rancidone/cat-light/pcb/CatLightPocket/CatLightPocket.kicad_pcb

## KiCad design pcb/CatLightPocket/CatLightPocket.kicad_pcb (2026-11-08)

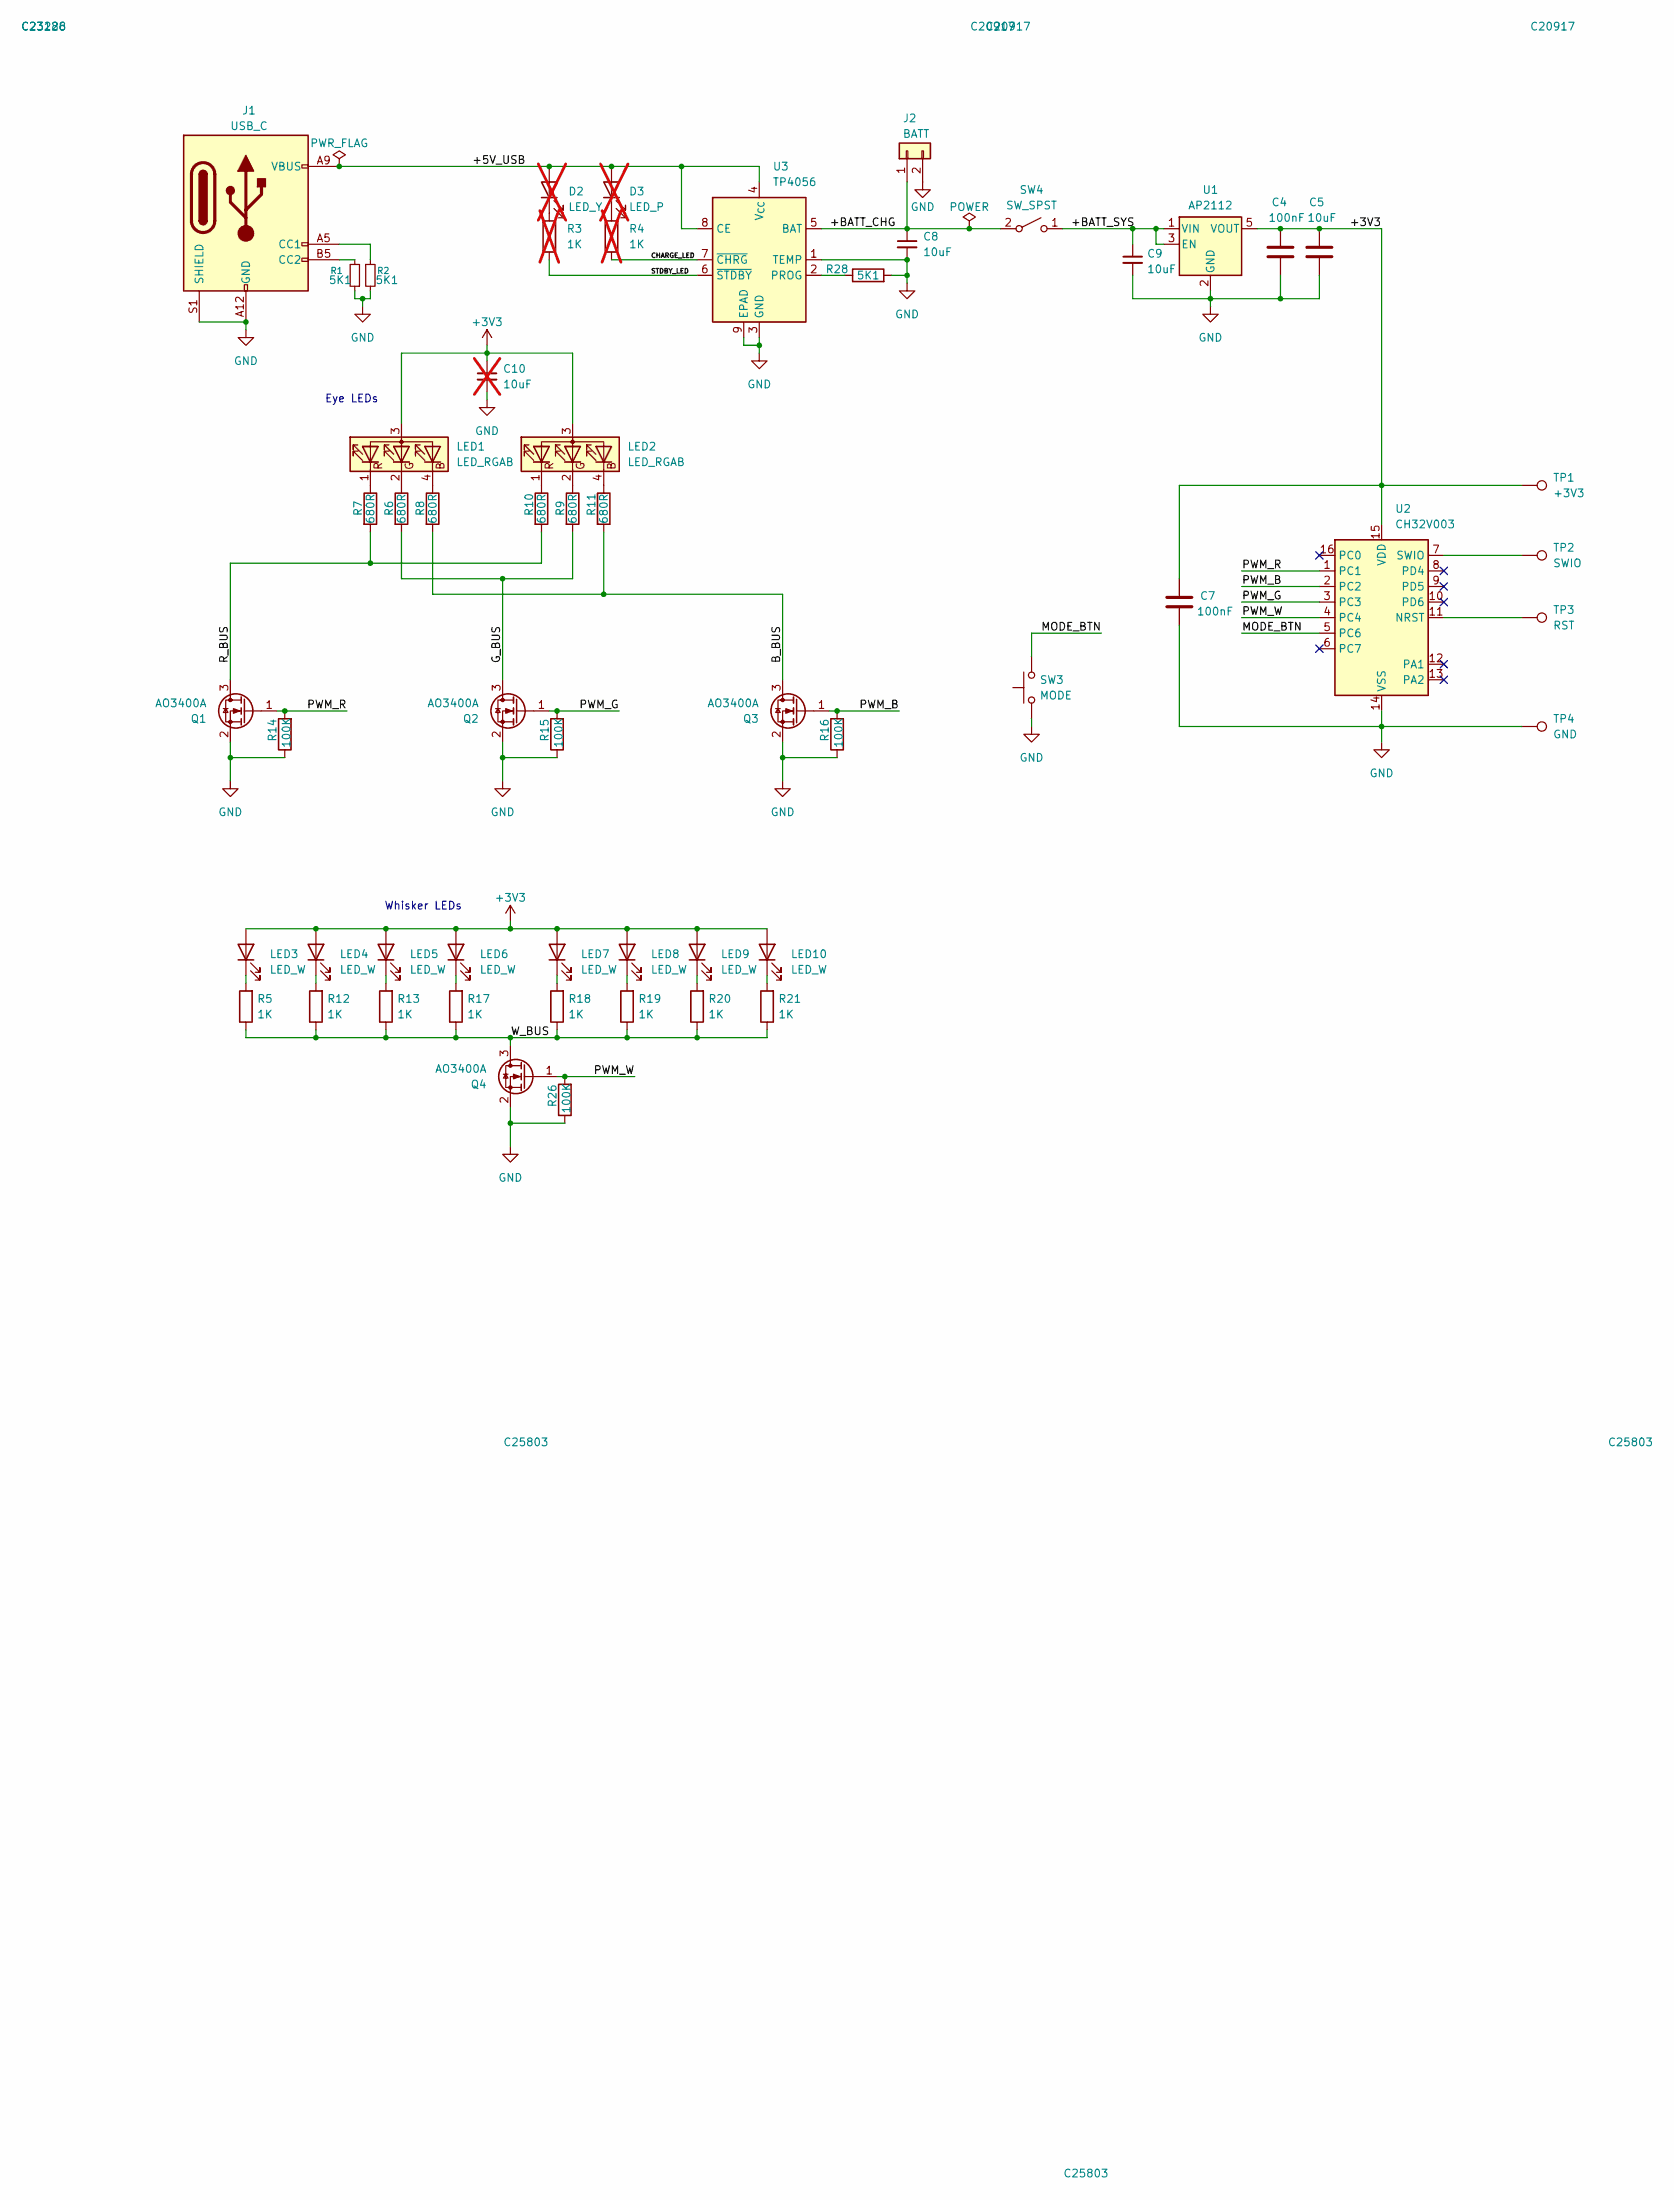
[picture p1: schematic CatLightPocket.kicad_sch]

Parts:
C4, C7: 100nF; C_0603_1608Metric_Pad1.08x0.95mm_HandSolder; LCSC C14663
C5: 10uF; C_0805_2012Metric_Pad1.18x1.45mm_HandSolder; LCSC C15850
C8, C9: 10uF; C_0805_2012Metric_Pad1.18x1.45mm_HandSolder
C10: 10uF; C_0805_2012Metric_Pad1.18x1.45mm_HandSolder; not fitted
D2: LED_Y; LED_0603_1608Metric_Pad1.05x0.95mm_HandSolder; not fitted
D3: LED_P; LED_0603_1608Metric_Pad1.05x0.95mm_HandSolder; not fitted
J1: USB_C; USB_C_Receptacle_HRO_TYPE-C-31-M-17
J2: BATT; JST_PH_B2B-PH-K_1x02_P2.00mm_Vertical
LED1, LED2: LED_RGAB; 0805 ARGB LED
LED3, LED4, LED5, LED6, LED7, LED8, LED9, LED10: LED_W; LED_0603_1608Metric_Pad1.05x0.95mm_HandSolder
Q1, Q2, Q3, Q4: AO3400A; SOT-23; LCSC C20917
R1, R2, R28: 5K1; R_0603_1608Metric_Pad0.98x0.95mm_HandSolder; LCSC C23186
R3, R4: 1K; R_0603_1608Metric_Pad0.98x0.95mm_HandSolder; LCSC C21190; not fitted
R5, R12, R13, R17, R18, R19, R20, R21: 1K; R_0603_1608Metric_Pad0.98x0.95mm_HandSolder; LCSC C21190
R6, R7, R8, R9, R10, R11: 680R; R_0603_1608Metric_Pad0.98x0.95mm_HandSolder; LCSC C23228
R14, R15, R16, R26: 100K; R_0603_1608Metric_Pad0.98x0.95mm_HandSolder; LCSC C25803
SW3: MODE; 6x3.5 Tactile Switch
SW4: SW_SPST; SW-MSK12C02
TP1: +3V3; TestPoint_Pad_D2.0mm
TP2: SWIO; TestPoint_Pad_D2.0mm
TP3: RST; TestPoint_Pad_D2.0mm
TP4: GND; TestPoint_Pad_D2.0mm
U1: AP2112; SOT-23-5_HandSoldering
U2: CH32V003; SOIC-16_3.9x9.9mm_P1.27mm
U3: TP4056; SOIC-8-1EP_3.9x4.9mm_P1.27mm_EP2.41x3.3mm; LCSC C16581

Connections:
+3V3: C4.1, C5.1, C7.1, C10.1, LED1.3 (A), LED2.3 (A), LED3.2 (A), LED4.2 (A), LED5.2 (A), LED6.2 (A), LED7.2 (A), LED8.2 (A), LED9.2 (A), LED10.2 (A), TP1.1 (1_1), U1.5 (VOUT), U2.15 (VDD)
/+5V_USB: D2.2 (A), D3.2 (A), J1.A9 (VBUS), J1.B9 (VBUS), U3.4 (V_{CC}), U3.8 (CE)
/+BATT_CHG: C8.1, J2.1, SW4.2 (A), U3.5 (BAT)
/+BATT_SYS: C9.1, SW4.1 (B), U1.1 (VIN), U1.3 (EN)
/B_BUS: Q3.3 (D), R8.2, R11.2
/CHARGE_LED: R4.1, U3.7 (~CHRG)
/G_BUS: Q2.3 (D), R6.2, R9.2
/MODE_BTN: SW3.2, U2.5 (PC6)
/PWM_B: Q3.1 (G), R16.2, U2.2 (PC2)
/PWM_G: Q2.1 (G), R15.2, U2.3 (PC3)
/PWM_R: Q1.1 (G), R14.2, U2.1 (PC1)
/PWM_W: Q4.1 (G), R26.2, U2.4 (PC4)
/R_BUS: Q1.3 (D), R7.2, R10.2
/STDBY_LED: R3.1, U3.6 (~STDBY)
/W_BUS: Q4.3 (D), R5.1, R12.1, R13.1, R17.1, R18.1, R19.1, R20.1, R21.1
GND: C4.2, C5.2, C7.2, C8.2, C9.2, C10.2, J1.A12 (GND), J1.B12 (GND), J1.S1 (SHIELD), J2.2, Q1.2 (S), Q2.2 (S), Q3.2 (S), Q4.2 (S), R1.1, R2.2, R14.1, R15.1, R16.1, R26.1, R28.2, SW3.1, TP4.1 (1_1), U1.2 (GND), U2.14 (VSS), U3.1 (TEMP), U3.3 (GND), U3.9 (EPAD)
unnamed: D2.1 (K), R3.2
unnamed: D3.1 (K), R4.2
unnamed: J1.A5 (CC1), R2.1
unnamed: J1.B5 (CC2), R1.2
unnamed: LED1.4 (BK), R8.1
unnamed: LED1.2 (GK), R6.1
unnamed: LED1.1 (RK), R7.1
unnamed: LED2.4 (BK), R11.1
unnamed: LED2.2 (GK), R9.1
unnamed: LED2.1 (RK), R10.1
unnamed: LED3.1 (K), R5.2
unnamed: LED4.1 (K), R12.2
unnamed: LED5.1 (K), R13.2
unnamed: LED6.1 (K), R17.2
unnamed: LED7.1 (K), R18.2
unnamed: LED8.1 (K), R19.2
unnamed: LED9.1 (K), R20.2
unnamed: LED10.1 (K), R21.2
unnamed: TP2.1 (1_1), U2.7 (SWIO)
unnamed: TP3.1 (1_1), U2.11 (NRST)
unnamed: R28.1, U3.2 (PROG)

Notes on the sheet:
Eye LEDs
Whisker LEDs

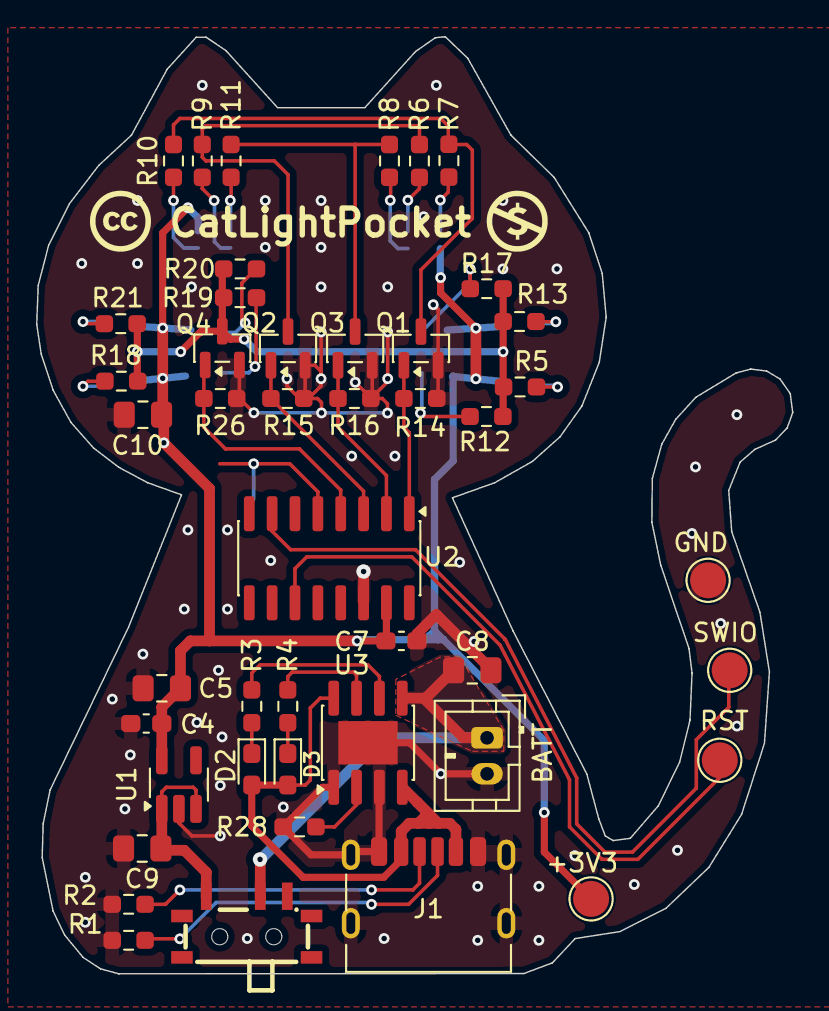
[picture p2: board CatLightPocket.kicad_pcb from above]

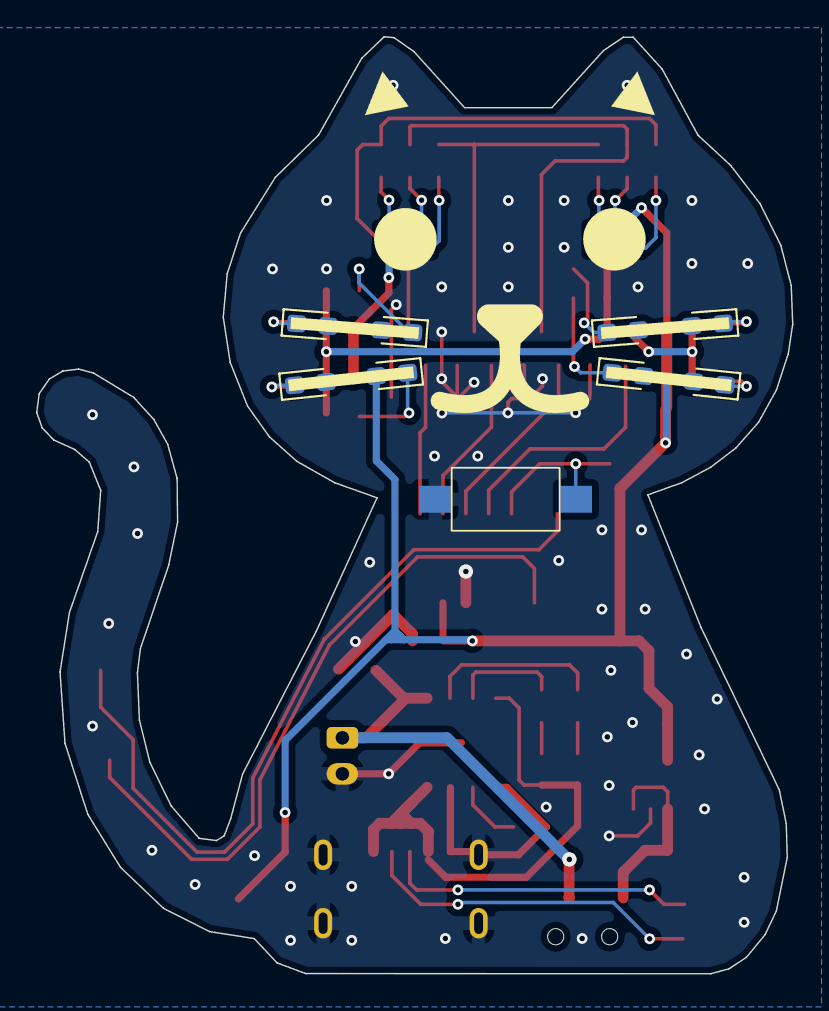
[picture p3: board CatLightPocket.kicad_pcb from below]

Board: 2 copper layers, 42.0 x 52.1 mm, 56 parts (11 on the bottom side), 37 nets.
