rancidone/cat-light/ESPLight-dev/ESPLight-dev.kicad_pcb

## KiCad design ESPLight-dev/ESPLight-dev.kicad_pcb (2026-03-18)

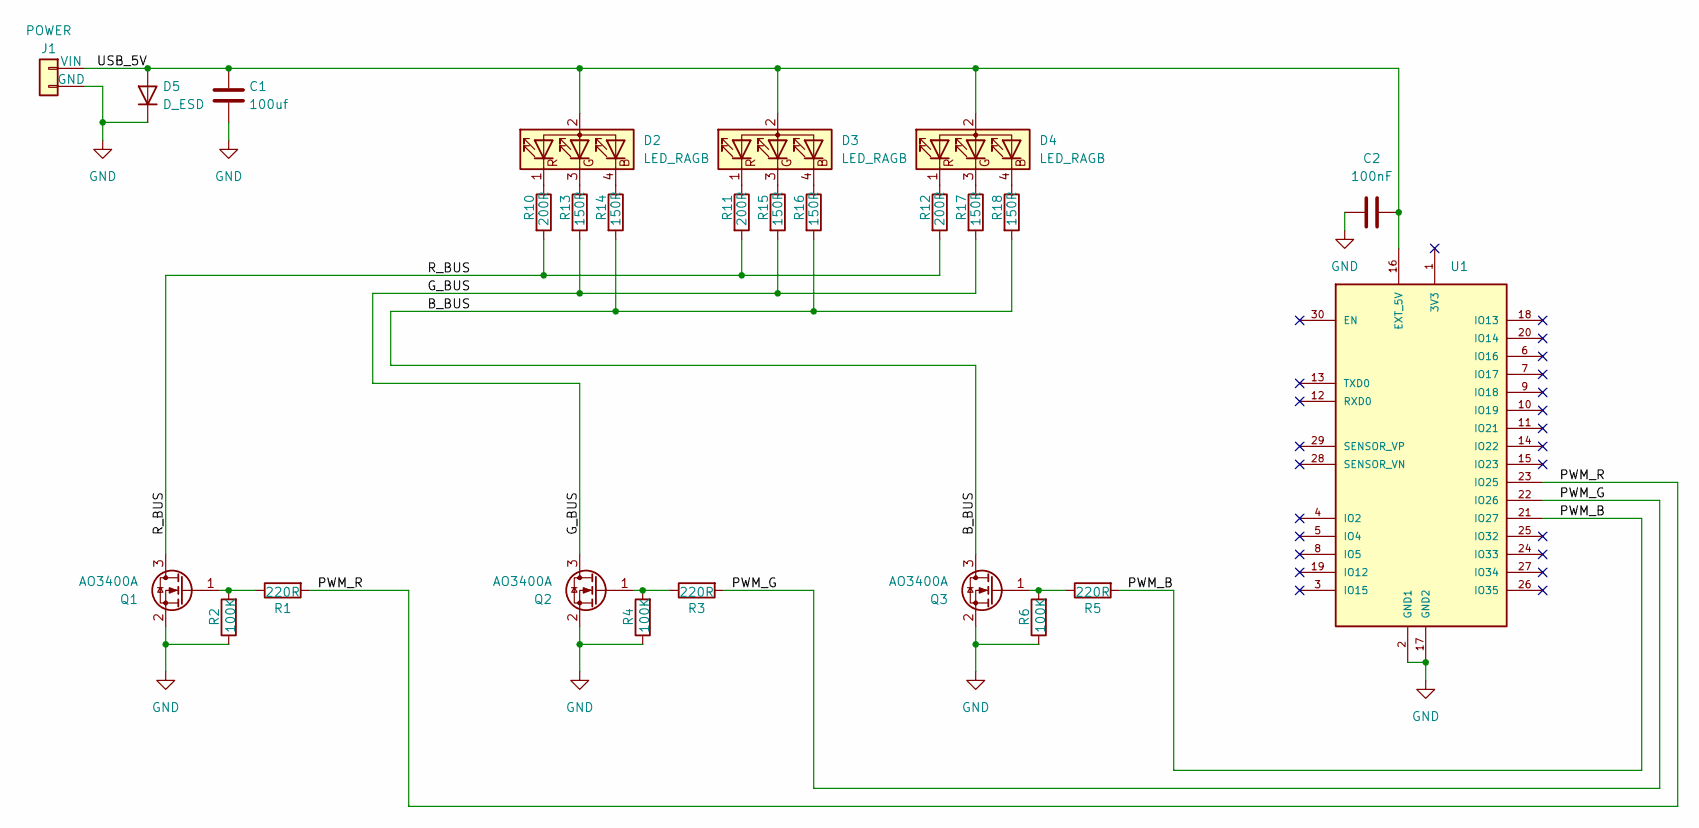
[picture p4: schematic ESPLight-dev.kicad_sch]

Parts:
C1: 100uf; C_Radial_D6.3mm_H5.0mm_P2.50mm
C2: 100nF; C_0603_1608Metric
D2, D3, D4: LED_RAGB; LED_D5.0mm-4_RGB
D5: D_ESD; D_SOD-523
J1: POWER; PinHeader_1x02_P2.54mm_Vertical
Q1, Q2, Q3: AO3400A; SOT-23
R1, R3, R5: 220R; R_0603_1608Metric
R2, R4, R6: 100K; R_0603_1608Metric
R10, R11, R12: 200R; R_0603_1608Metric
R13, R14, R15, R16, R17, R18: 150R; R_0603_1608Metric
U1: DEVKIT_V1_ESP32-WROOM-32; ESP32_30pin

Connections:
/B_BUS: Q3.3 (D), R14.2, R16.2, R18.2
/G_BUS: Q2.3 (D), R13.2, R15.2, R17.2
/PWM_B: R5.2, U1.21 (IO27)
/PWM_G: R3.2, U1.22 (IO26)
/PWM_R: R1.2, U1.23 (IO25)
/R_BUS: Q1.3 (D), R10.2, R11.2, R12.2
/USB_5V: C1.1, C2.2, D2.2 (A), D3.2 (A), D4.2 (A), D5.2 (A), J1.1 (VIN), U1.16 (EXT_5V)
GND: C1.2, C2.1, D5.1 (K), J1.2 (GND), Q1.2 (S), Q2.2 (S), Q3.2 (S), R2.1, R4.1, R6.1, U1.2 (GND1), U1.17 (GND2)
unnamed: D2.4 (BK), R14.1
unnamed: D2.3 (GK), R13.1
unnamed: D2.1 (RK), R10.1
unnamed: D3.4 (BK), R16.1
unnamed: D3.3 (GK), R15.1
unnamed: D3.1 (RK), R11.1
unnamed: D4.4 (BK), R18.1
unnamed: D4.3 (GK), R17.1
unnamed: D4.1 (RK), R12.1
unnamed: Q1.1 (G), R1.1, R2.2
unnamed: Q2.1 (G), R3.1, R4.2
unnamed: Q3.1 (G), R5.1, R6.2

Board: 2 copper layers, 26 parts (0 on the bottom side), 20 nets, no tracks yet.
