rancidone/cat-light/main/behavior.h

#pragma once

#include "behavior_types.h"

// Scalar behavior types
extern const scalar_behavior_t behavior_solid;
extern const scalar_behavior_t behavior_pulse;

// RGB behavior types
extern const rgb_behavior_t behavior_solid_rgb;
extern const rgb_behavior_t behavior_pulse_rgb;
extern const rgb_behavior_t behavior_flicker;
extern const rgb_behavior_t behavior_rainbow;
