rancidone/cat-light/(commit log)

2026-03-18 Move pcb files
2026-05-25 Add captive portal, web UI, cjson, and CatLightPocket PCB
    - Add DNS server task for SoftAP captive portal (redirects all queries to 192.168.4.1)
    - Add HTTP redirects for common captive-portal probe URIs
    - Fix wifi credential handler: copy strings before freeing cJSON tree, reboot on save
    - Switch from idf json component to espressif/cjson; add to dependencies
    - Add littlefs partition image build step and sdkconfig.defaults for 4MB flash
    - Fix minimum brightness floor (0.0f → 0.001f to prevent fully-off on dim)
    - Add www/ web UI assets (index.html, app.html, alpine.js, pico.css)
    - Add CatLightPocket KiCad pocket edition PCB project
    - Add web-ui.md design doc; update KiCad project format to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
2026-05-25 Add CH32V003 pocket firmware (ch32v003fun, bare-metal)
    Ports the three built-in light modes (fade, spooky, rainbow) to the
    CatLightPocket board. No RTOS, no networking, no scripting engine —
    just a 33 Hz main loop with SysTick timing and TIM1/TIM2 PWM output.
    Pin assignments (from schematic):
    PC1 → PWM_R TIM2_CH4, partial remap 1
    PC2 → PWM_B TIM2_CH2, partial remap 1
    PC3 → PWM_G TIM1_CH3, no remap
    PC4 → PWM_W TIM1_CH4, no remap
    PC6 → MODE_BTN, active low, external pull-up
    Build: make build (in pocket/)
    Flash: make flash (requires minichlink + WCH-LinkE)
2026-05-25 Reorganize: move ESP32 firmware into esp32/, update CLAUDE.md
2026-05-25 Add wch-link-rv-mode.py to switch LinkE to RISC-V mode on macOS
2026-05-25 Fix PWM CHCTLR bit shifts, add board-test firmware
2026-05-25 Add hold-button brightness control — 5 levels, medium default
2026-11-09 Fix Pocket timer rollover and retire ESP32 documentation
